ferdinandkeil/humidor-steuerung-hw/README.md

# Humidor Steuerung (Hardware)

Die aktuelle Version der Steuerung ist v35. Gefertigt wurden nur v31 und v35.

Wenn nicht anders angegeben stehen die Dateien unter der TAPR Open Hardware License (siehe LICENSE).
