ferdinandkeil/humidor-steuerung-hw/sensor_board_v10.brd

## EAGLE design sensor_board_v10.brd (2012-12-13)

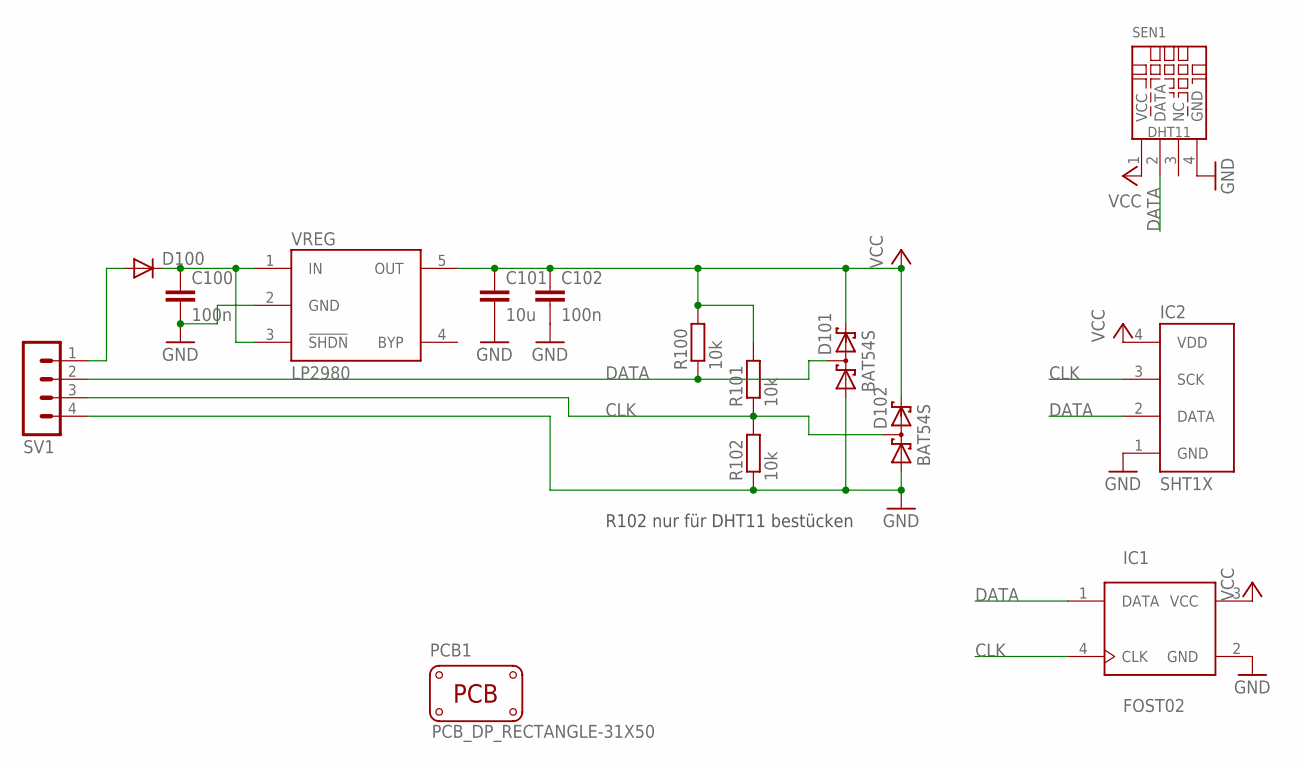
[picture p1: schematic sensor_board_v10.sch]

Parts:
C100, C102: 100n; C0805
C101: 10u; C0805
D100: DIODE-SOD123; SOD123
D101, D102: BAT54S; SOT23
IC1: FOST02
IC2: SHT1X
PCB1: PCB_DP_RECTANGLE-31X50; DP5031_V1
R100, R101, R102: 10k; R0805
SEN1: DHT11
SV1: MA04-1
VREG: LP2980; SOT-23-5

Connections:
CLK: D102.3 (C1A2), IC1.4 (CLK), IC2.3 (SCK), R101.1, R102.2, SV1.3
DATA: D101.3 (C1A2), IC1.1 (DATA), IC2.2 (DATA), R100.1, SEN1.2 (DATA), SV1.2
GND: C100.2, C101.2, C102.2, D101.1 (A1), D102.1 (A1), IC1.2 (GND), IC2.1 (GND), R102.1, SEN1.4 (GND), SV1.4, VREG.2 (GND)
unnamed: C100.1, D100.C, VREG.1 (IN), VREG.3 (!SHDN)
unnamed: D100.A, SV1.1
VCC: C101.1, C102.1, D101.2 (C2), D102.2 (C2), IC1.3 (VCC), IC2.4 (VDD), R100.2, R101.2, SEN1.1 (VCC), VREG.5 (OUT)

Notes on the sheet:
R102 nur für DHT11 bestücken

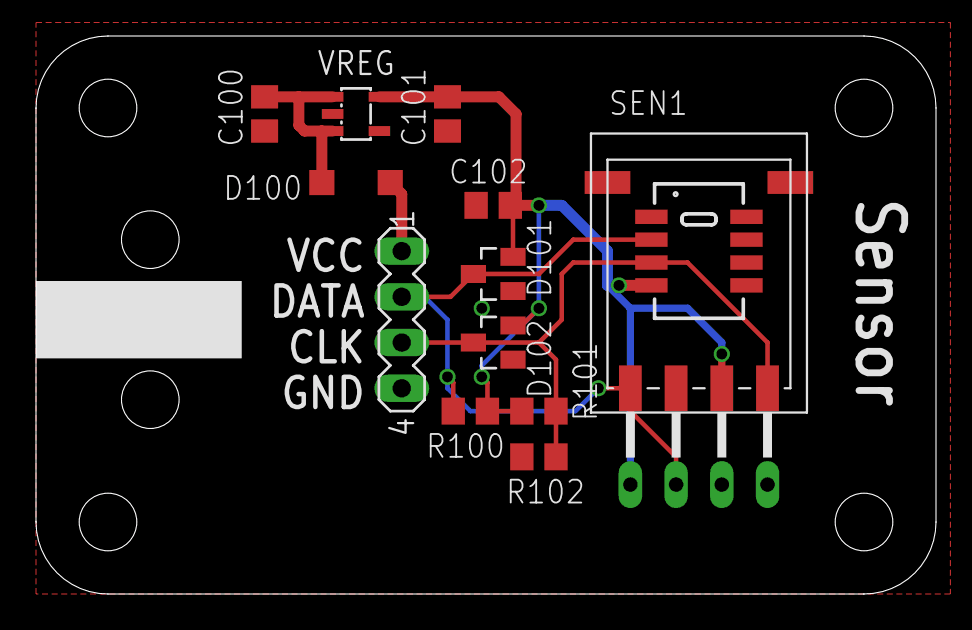
[picture p2: board sensor_board_v10.brd from above]

Board: 2 copper layers, 50.0 x 31.0 mm, 16 parts (1 on the bottom side), 6 nets.

Other parts of the board:
U$1: ICON_LOGO_HUMI_CONTR
