ferdinandkeil/humidor-steuerung-hw/humidor_controller_v33.brd

## EAGLE design humidor_controller_v33.brd (2012-12-13, an earlier design)

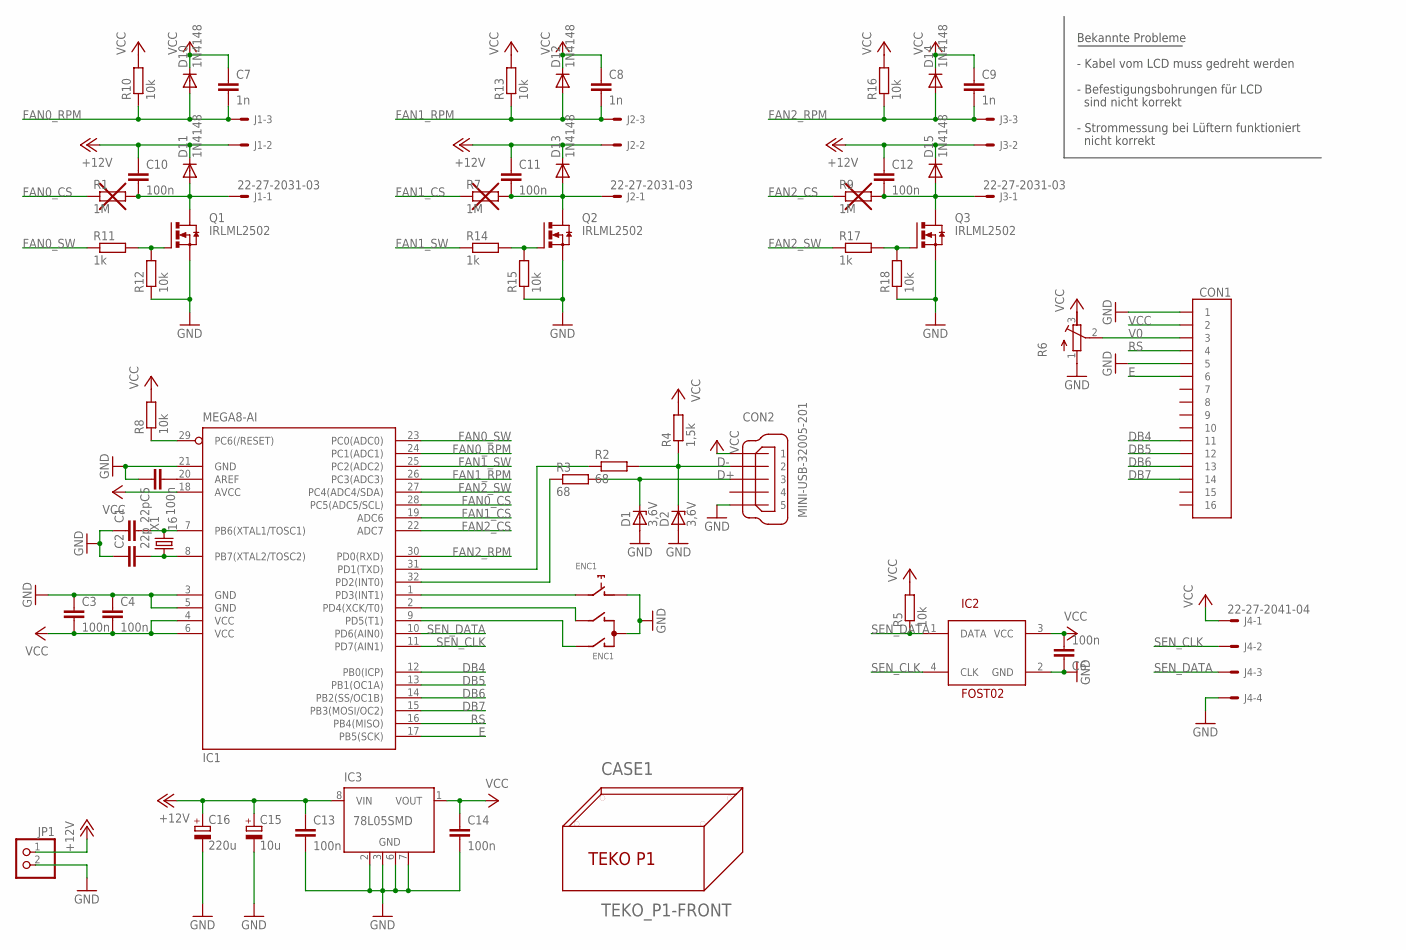
[picture p3: schematic humidor_controller_v33.sch]

Parts:
C1, C2: 22p; C0805
C3, C4, C5, C6, C10, C11, C12, C13, C14: 100n; C0805
C7, C8, C9: 1n; C0805
C15: 10u; PANASONIC_D
C16: 220u; PANASONIC_G
CASE1: TEKO_P1-FRONT; TEKO_P1_FRONT
CON1: 52207-16
CON2: MINI-USB-32005-201; 32005-201
D1, D2: 3,6V; SOD80C
D10, D11, D12, D13, D14, D15: 1N4148; SOD323-R
ENC1: NOBLE_RE0124; RE0124
IC1: MEGA8-AI; TQFP32-08
IC2: FOST02
IC3: 78L05SMD; SO08
J1, J2, J3: 22-27-2031-03; 6410-03
J4: 22-27-2041-04; 6410-04
JP1: PINHD-1X2; 1X02
Q1, Q2, Q3: IRLML2502; SOT23
R1, R7, R9: 1M; R0805
R2, R3: 68; R0805
R4: 1,5k; R0805
R5, R8, R10, R12, R13, R15, R16, R18: 10k; R0805
R6: R-TRIMM4G/J; RTRIM4G/J
R11, R14, R17: 1k; R0805
X1: 16; HC49UP

Connections:
+12V: C10.1, C11.1, C12.1, C13.1, C15.+, C16.+, D11.C, D13.C, D15.C, IC3.8 (VIN), J1.2, J2.2, J3.2, JP1.1
D+: CON2.3, D1.C, R3.2
D-: CON2.2, D2.C, R2.2, R4.1
DB4: CON1.11, IC1.12 (PB0(ICP))
DB5: CON1.12, IC1.13 (PB1(OC1A))
DB6: CON1.13, IC1.14 (PB2(SS/OC1B))
DB7: CON1.14, IC1.15 (PB3(MOSI/OC2))
E: CON1.6, IC1.17 (PB5(SCK))
FAN0_CS: IC1.28 (PC5(ADC5/SCL)), R1.1
FAN0_CS_: C10.2, D11.A, J1.1, Q1.3 (D), R1.2
FAN0_RPM: C7.2, D10.A, IC1.24 (PC1(ADC1)), J1.3, R10.1
FAN0_SW: IC1.23 (PC0(ADC0)), R11.1
FAN1_CS: IC1.19 (ADC6), R7.1
FAN1_CS_: C11.2, D13.A, J2.1, Q2.3 (D), R7.2
FAN1_RPM: C8.2, D12.A, IC1.26 (PC3(ADC3)), J2.3, R13.1
FAN1_SW: IC1.25 (PC2(ADC2)), R14.1
FAN2_CS: IC1.22 (ADC7), R9.1
FAN2_CS_: C12.2, D15.A, J3.1, Q3.3 (D), R9.2
FAN2_RPM: C9.2, D14.A, IC1.30 (PD0(RXD)), J3.3, R16.1
FAN2_SW: IC1.27 (PC4(ADC4/SDA)), R17.1
GND: C1.1, C2.1, C3.1, C4.1, C5.1, C6.1, C13.2, C14.2, C15.-, C16.-, CON1.1, CON1.5, CON2.5, D1.A, D2.A, ENC1.+ (1), ENC1.C, IC1.3 (GND), IC1.5 (GND), IC1.21 (GND), IC2.2 (GND), IC3.2 (GND), IC3.3 (GND), IC3.6 (GND), IC3.7 (GND), J4.4, JP1.2, Q1.2 (S), Q2.2 (S), Q3.2 (S), R6.1 (E), R12.1, R15.1, R18.1
unnamed: IC1.29 (PC6(/RESET)), R8.1
unnamed: C2.2, IC1.8 (PB7(XTAL2/TOSC2)), X1.1
unnamed: C1.2, IC1.7 (PB6(XTAL1/TOSC1)), X1.2
unnamed: Q2.1 (G), R14.2, R15.2
unnamed: Q3.1 (G), R17.2, R18.2
unnamed: C5.2, IC1.20 (AREF)
unnamed: Q1.1 (G), R11.2, R12.2
unnamed: IC1.31 (PD1(TXD)), R2.1
unnamed: ENC1.- (2), IC1.1 (PD3(INT1))
unnamed: ENC1.B, IC1.2 (PD4(XCK/T0))
unnamed: ENC1.A, IC1.9 (PD5(T1))
unnamed: IC1.32 (PD2(INT0)), R3.1
RS: CON1.4, IC1.16 (PB4(MISO))
SEN_CLK: IC1.11 (PD7(AIN1)), IC2.4 (CLK), J4.2
SEN_DATA: IC1.10 (PD6(AIN0)), IC2.1 (DATA), J4.3, R5.1
V0: CON1.3, R6.2 (S)
VCC: C3.2, C4.2, C6.2, C7.1, C8.1, C9.1, C14.1, CON1.2, CON2.1, D10.C, D12.C, D14.C, IC1.4 (VCC), IC1.6 (VCC), IC1.18 (AVCC), IC2.3 (VCC), IC3.1 (VOUT), J4.1, R4.2, R5.2, R6.3 (A), R8.2, R10.2, R13.2, R16.2

Notes on the sheet:
Bekannte Probleme
- Kabel vom LCD muss gedreht werden
- Befestigungsbohrungen für LCD
sind nicht korrekt
- Strommessung bei Lüftern funktioniert
nicht korrekt

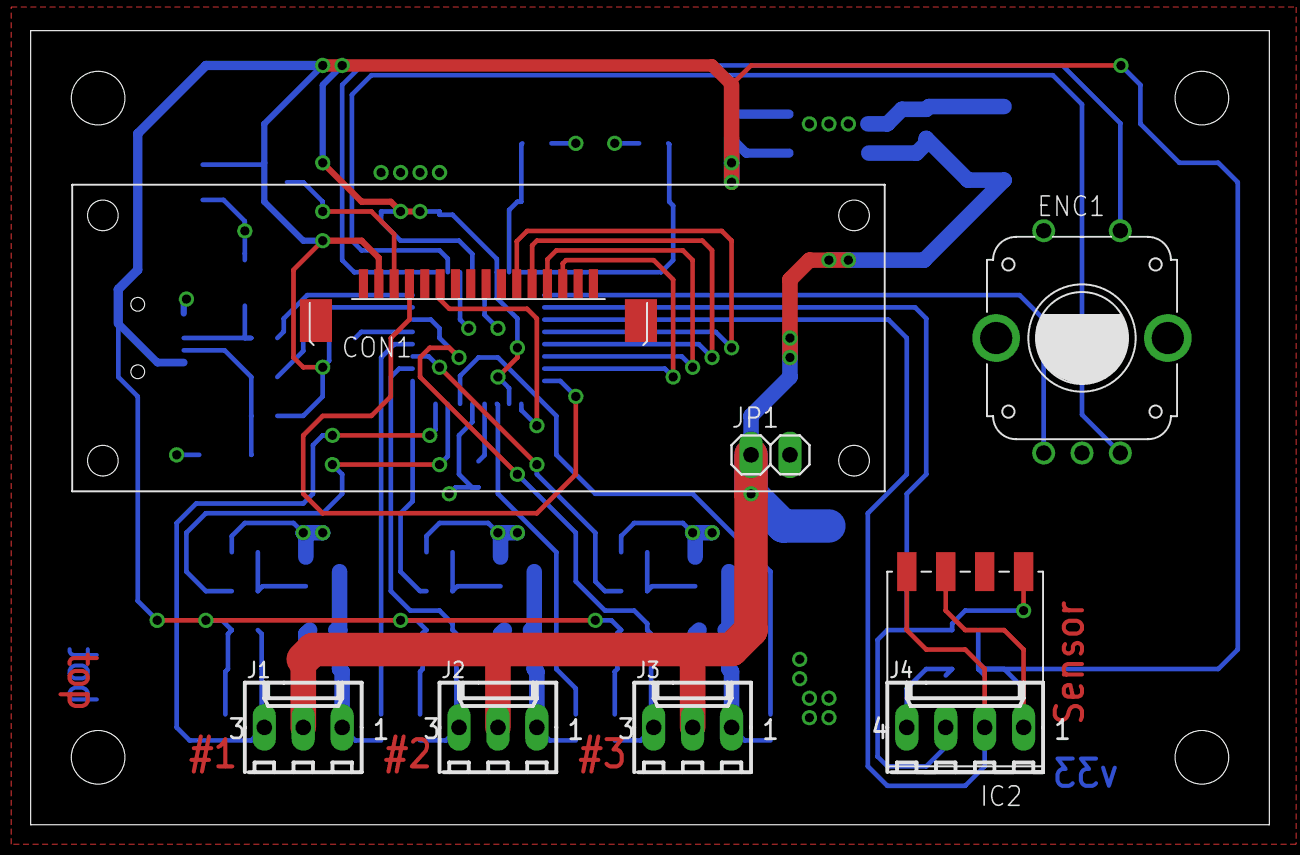
[picture p4: board humidor_controller_v33.brd from above]

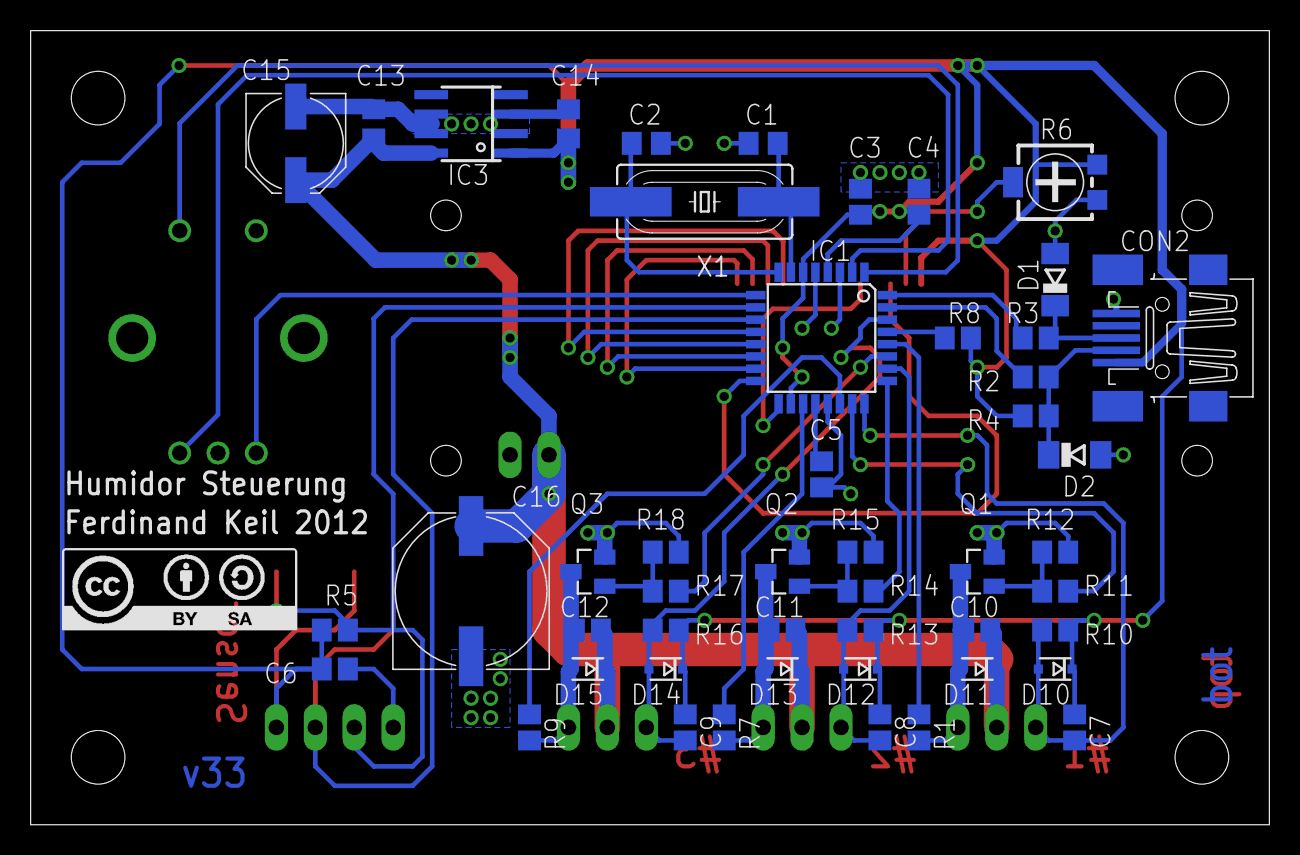
[picture p5: board humidor_controller_v33.brd from below]

Board: 2 copper layers, 80.8 x 51.8 mm, 60 parts (50 on the bottom side), 38 nets.

Other parts of the board:
U$1: LCD_HMC16223SG
U$2: CC-BY-SA
