ferdinandkeil/humidor-steuerung-hw/humidor_controller_v35.brd

## EAGLE design humidor_controller_v35.brd (2012-12-13)

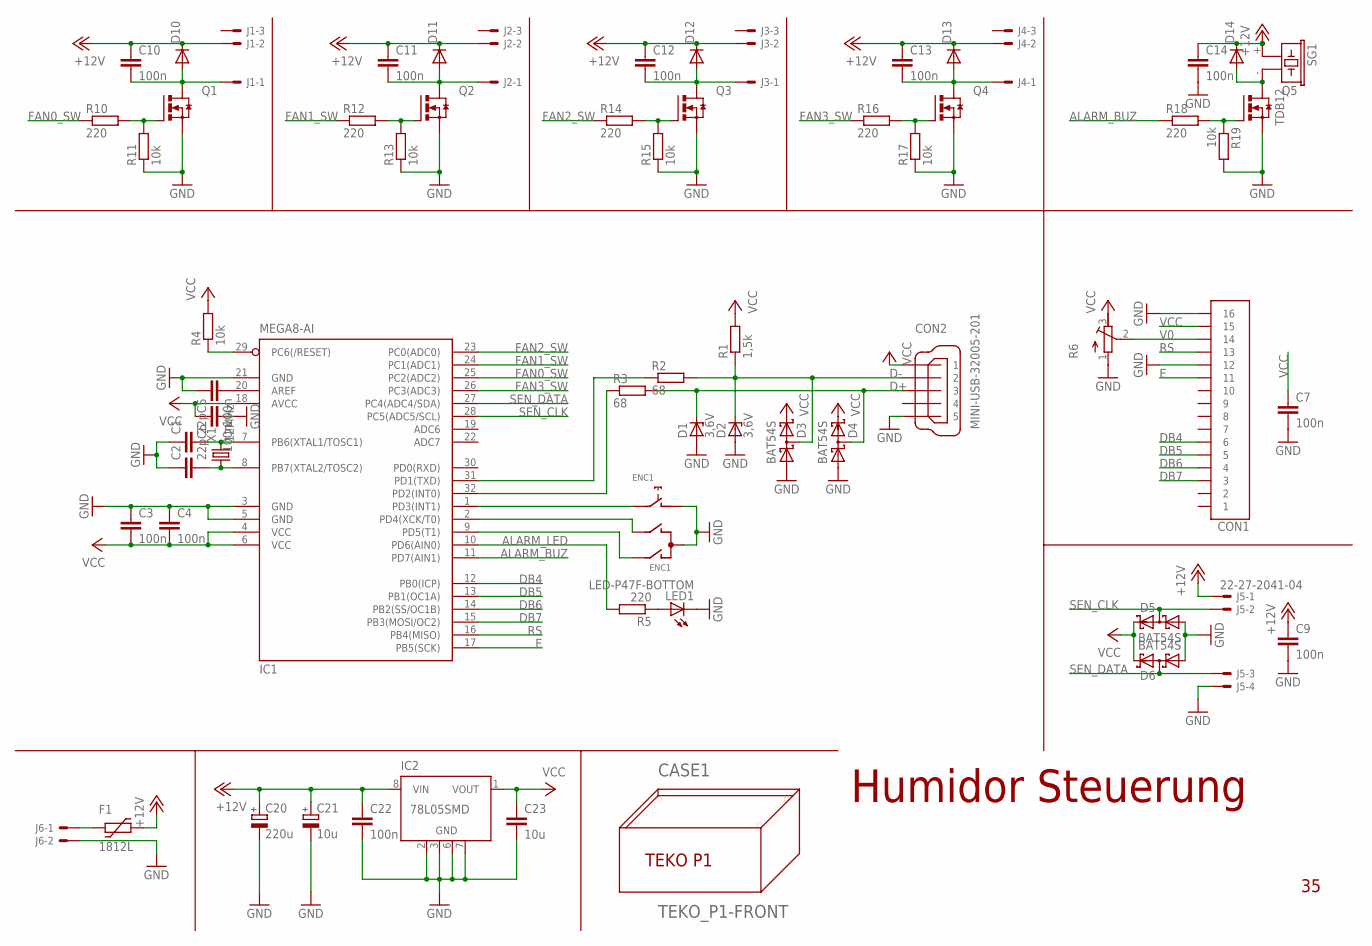
[picture p6: schematic humidor_controller_v35.sch]

Parts:
C1, C2: 22p; C0805
C3, C4, C5, C6, C7, C9, C10, C11, C12, C13, C14, C22: 100n; C0805
C20: 220u; PANASONIC_G
C21: 10u; PANASONIC_B
C23: 10u; C0805
CASE1: TEKO_P1-FRONT; TEKO_P1_FRONT
CON1: 52207-16
CON2: MINI-USB-32005-201; 32005-201
D1, D2: 3,6V; SOD80C
D3, D4, D5, D6: BAT54S; SOT23
D10, D11, D12, D13, D14: DIODE-SOD123; SOD123
ENC1: NOBLE_RE0124; RE0124
F1: 1812L
IC1: MEGA8-AI; TQFP32-08
IC2: 78L05SMD; SO08
J1, J2, J3, J4: 22-27-2031-03; 6410-03
J5: 22-27-2041-04; 6410-04
J6: 22-27-2021-02; 6410-02
LED1: LED-P47F-BOTTOM; P47F-BOTTOM
Q1, Q2, Q3, Q4, Q5: N-HEXFET_SOT23-IRLML2502; SOT23
R1: 1,5k; R0805
R2, R3: 68; R0805
R4, R11, R13, R15, R17, R19: 10k; R0805
R5, R10, R12, R14, R16, R18: 220; R0805
R6: R-TRIMM4G/J; RTRIM4G/J
SG1: TDB12; TDB
X1: 12MHz; HC49UP

Connections:
+12V: C9.1, C10.1, C11.1, C12.1, C13.1, C14.1, C20.+, C21.+, C22.1, D10.C, D11.C, D12.C, D13.C, D14.C, F1.P$2 (2), IC2.8 (VIN), J1.2, J2.2, J3.2, J4.2, J5.1, SG1.+ (1)
ALARM_BUZ: IC1.11 (PD7(AIN1)), R18.1
ALARM_LED: IC1.10 (PD6(AIN0)), R5.2
D+: CON2.3, D1.C, D4.3 (C1A2), R3.2
D-: CON2.2, D2.C, D3.3 (C1A2), R1.1, R2.2
DB4: CON1.6, IC1.12 (PB0(ICP))
DB5: CON1.5, IC1.13 (PB1(OC1A))
DB6: CON1.4, IC1.14 (PB2(SS/OC1B))
DB7: CON1.3, IC1.15 (PB3(MOSI/OC2))
E: CON1.11, IC1.17 (PB5(SCK))
FAN0_CS: C10.2, D10.A, J1.1, Q1.3 (D)
FAN0_SW: IC1.25 (PC2(ADC2)), R10.1
FAN1_CS: C11.2, D11.A, J2.1, Q2.3 (D)
FAN1_SW: IC1.24 (PC1(ADC1)), R12.1
FAN2_CS: C12.2, D12.A, J3.1, Q3.3 (D)
FAN2_CS1: C13.2, D13.A, J4.1, Q4.3 (D)
FAN2_SW: IC1.23 (PC0(ADC0)), R14.1
FAN3_SW: IC1.26 (PC3(ADC3)), R16.1
GND: C1.1, C2.1, C3.1, C4.1, C5.1, C6.2, C7.2, C9.2, C14.2, C20.-, C21.-, C22.2, C23.2, CON1.12, CON1.16, CON2.5, D1.A, D2.A, D3.1 (A1), D4.1 (A1), D5.1 (A1), D6.1 (A1), ENC1.+ (1), ENC1.C, IC1.3 (GND), IC1.5 (GND), IC1.21 (GND), IC2.2 (GND), IC2.3 (GND), IC2.6 (GND), IC2.7 (GND), J5.4, J6.2, LED1.C, Q1.2 (S), Q2.2 (S), Q3.2 (S), Q4.2 (S), Q5.2 (S), R6.1 (E), R11.1, R13.1, R15.1, R17.1, R19.2
unnamed: IC1.29 (PC6(/RESET)), R4.1
unnamed: C2.2, IC1.8 (PB7(XTAL2/TOSC2)), X1.1
unnamed: C1.2, IC1.7 (PB6(XTAL1/TOSC1)), X1.2
unnamed: Q2.1 (G), R12.2, R13.2
unnamed: Q3.1 (G), R14.2, R15.2
unnamed: Q4.1 (G), R16.2, R17.2
unnamed: C5.2, IC1.20 (AREF)
unnamed: LED1.A, R5.1
unnamed: Q1.1 (G), R10.2, R11.2
unnamed: IC1.31 (PD1(TXD)), R2.1
unnamed: F1.P$1 (1), J6.1
unnamed: ENC1.- (2), IC1.1 (PD3(INT1))
unnamed: ENC1.B, IC1.2 (PD4(XCK/T0))
unnamed: ENC1.A, IC1.9 (PD5(T1))
unnamed: IC1.32 (PD2(INT0)), R3.1
unnamed: D14.A, Q5.3 (D), SG1.- (2)
unnamed: Q5.1 (G), R18.2, R19.1
RS: CON1.13, IC1.16 (PB4(MISO))
SEN_CLK: D5.3 (C1A2), IC1.28 (PC5(ADC5/SCL)), J5.2
SEN_DATA: D6.3 (C1A2), IC1.27 (PC4(ADC4/SDA)), J5.3
V0: CON1.14, R6.2 (S)
VCC: C3.2, C4.2, C6.1, C7.1, C23.1, CON1.15, CON2.1, D3.2 (C2), D4.2 (C2), D5.2 (C2), D6.2 (C2), IC1.4 (VCC), IC1.6 (VCC), IC1.18 (AVCC), IC2.1 (VOUT), R1.2, R4.2, R6.3 (A)

Notes on the sheet:
Humidor Steuerung

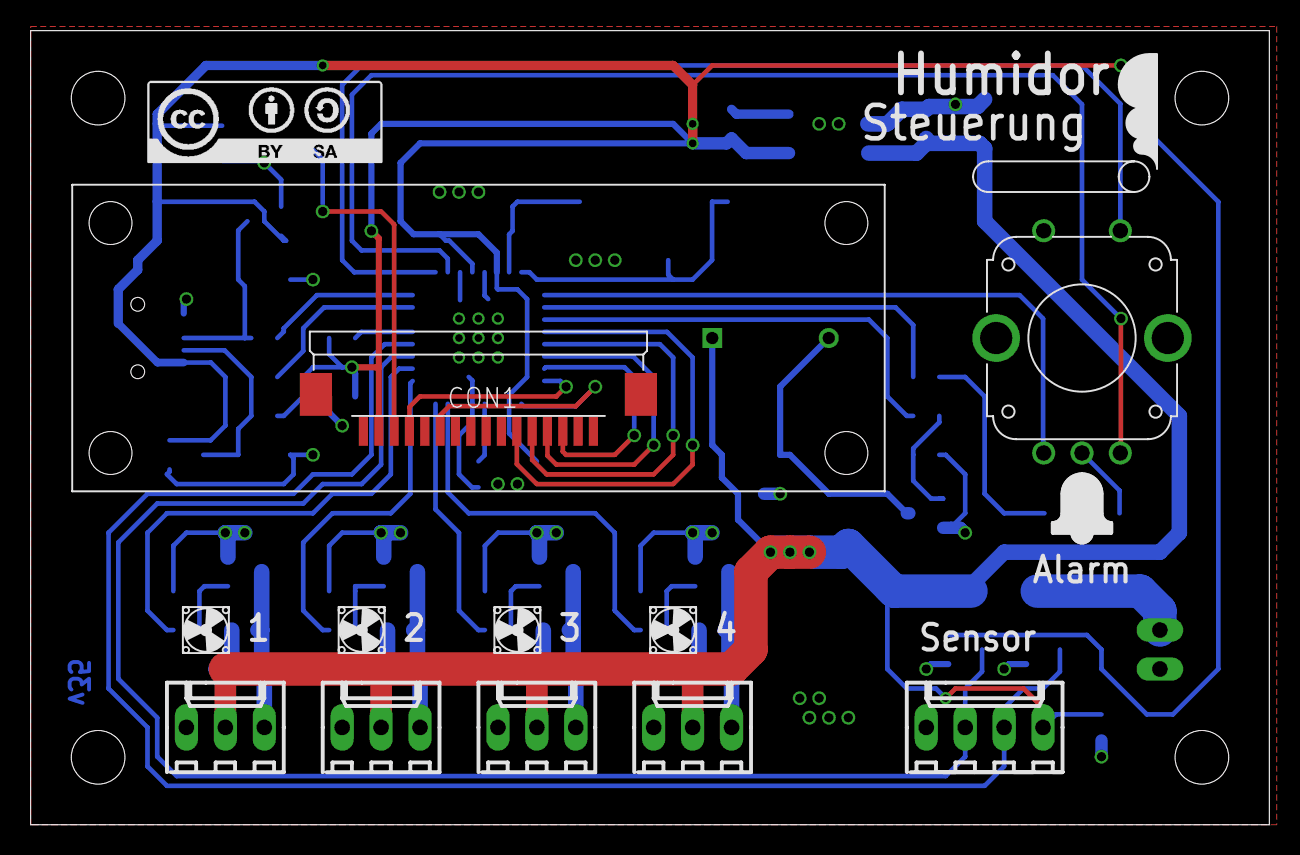
[picture p7: board humidor_controller_v35.brd from above]

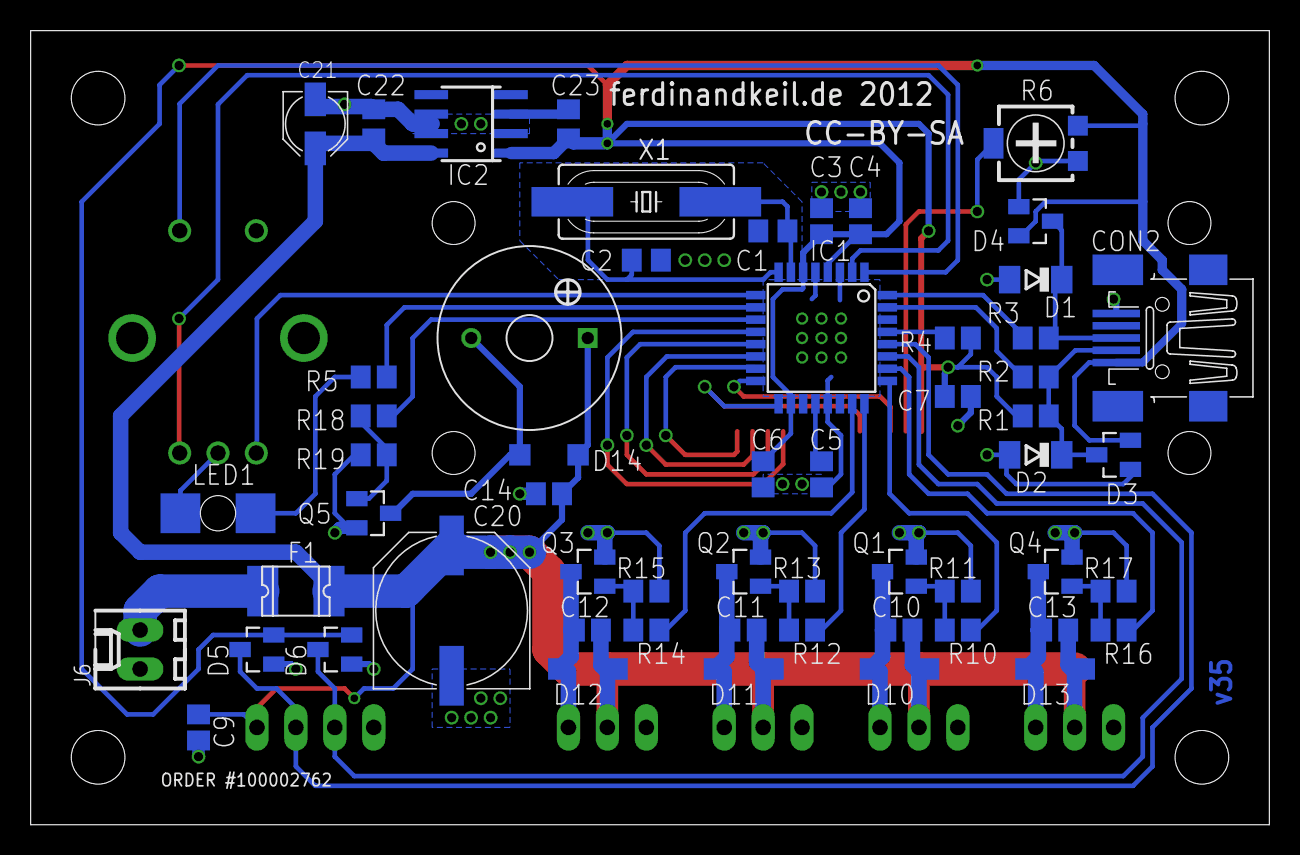
[picture p8: board humidor_controller_v35.brd from below]

Board: 2 copper layers, 80.8 x 51.8 mm, 72 parts (57 on the bottom side), 41 nets.

Other parts of the board:
U$1: LCD_HMC16223SG
U$2: CC-BY-SA
U$3: ICON_LOGO_HUMI_CONTR
U$4, U$5, U$6, U$7: ICON_FAN_3X3MM
